Elrindel/Arduino-Flash-Programmer/Schema/arduino-flash-programmer-sch.jpg

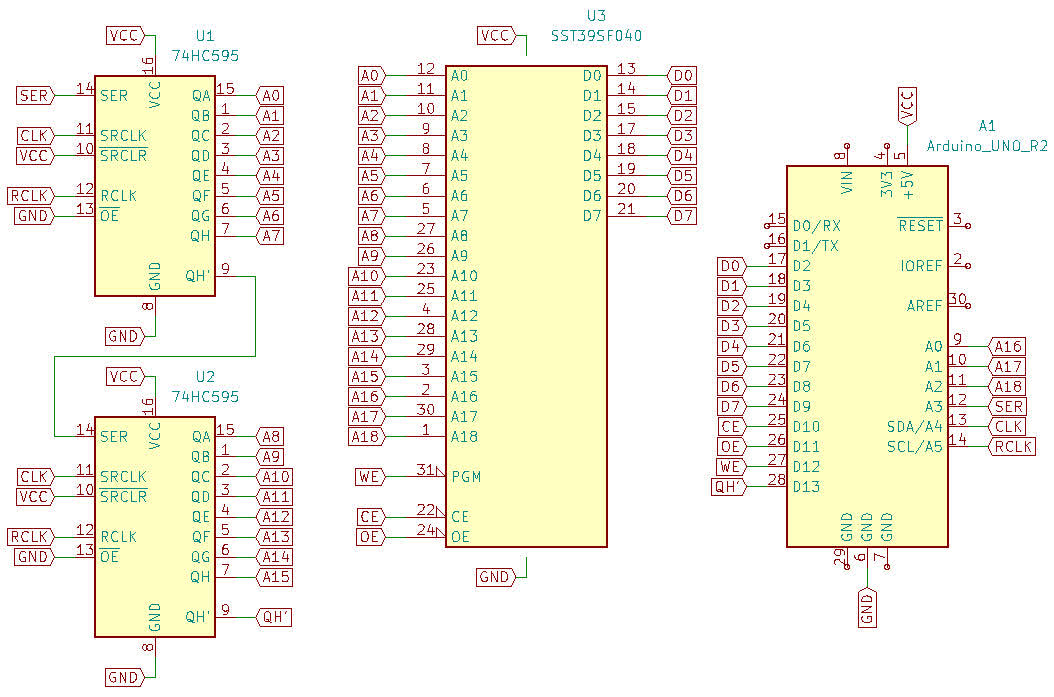
Schema/arduino-flash-programmer-sch.jpg
