Elrindel/Arduino-Flash-Programmer/Schema/FlashProgrammer.sch

## KiCad design Schema/FlashProgrammer.sch (2020-07-18)

Schematic: FlashProgrammer.sch

Parts:
A1: Arduino_UNO_R2
U1, U2: 74HC595; DIP-16_W7.62mm_Socket_LongPads
U3: SST39SF040; DIP-32_W15.24mm_Socket_LongPads
