Elrindel/Arduino-Flash-Programmer/(threads)

Thread 1 (2021-01-12):

Please confirm SST39SF010 and Linux compatibility

evgkarasev, 2021-01-12:
Hi!

Thank you for making your excellent piece of work public!

I have reviewed a lot of Arduino EEPROM programmers available within github and found that yours is capable to address large ROMs and use optimal hardware.
Please could confirm the compatibility with SST39SF010 and Linux environment as well.

Elrindel, 2021-01-12:
Hello,

Thank you for the comment.

The SST39SF010 flash memory is fully compatible (using the default sequence 1)!

I tested with a SST39SF040 and everything is OK.

The Python program is Linux compatible. You have to specify the right serial port with the -p argument.

evgkarasev, 2021-01-13:
Hi!

Thank you for your prompt reply!

Just read the newspaper article about retrocomputing:

https://www.nytimes.com/2021/01/08/style/retrocomputing.html

And remember our conversation, so it seems that flash ROM based floppy
emulators for old PCs could be a good business!

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

evgkarasev, 2021-01-16:
Hi, Elrindel!

Just completed the assembly on breadboard and flashed the Arduino with the code from Arduino/Uno-Nano/ folder.

I use Arduino Nano V3 and AT29C010A flash, assembled the schema without any modifications.

I run the code under Ubuntu 20.04.

# sudo chmod a+rw /dev/ttyUSB0
# python3 flashprogrammer.py -p /dev/ttyUSB0 -c I -x
FF FF
# python3 flashprogrammer.py -p /dev/ttyUSB0 -c E
Do you really want to erase the memory? [Y/n]y
# python3 flashprogrammer.py -p /dev/ttyUSB0 -c W -a 0 TEST WRITE DATA
[+] Ready to write 15 bytes
[+] Write 15/15 (15 bytes)
# python3 flashprogrammer.py -p /dev/ttyUSB0 -c R -a 0 -l 32 -x
E0 FF FF FF FF FF FF FF FF FF FF FF FF FF FF FF FF FF FF FF FF FF FF FF FF FF FF FF FF FF FF FF%

So it seems it doesn't work as expected...

Elrindel, 2021-01-16:
Hello,

I don't know why it doesn't work with your AT29C010A.
This memory does use sequence 1 like the SST39SF010.

I don't have an AT29C010A or any other Atmel flash memory, so I can't test.

Have you tested with a SST39SF010?

evgkarasev, 2021-01-16:
According to vendor datasheets AT29C010 and SST39SF010 are interchangeable, so don't think it could be an issue.
Now I trace the data on D0-D7 with logical analyzer, and it seems the issue is the timing...

Elrindel, 2021-01-16:
You can try the version for other Arduino boards: https://github.com/Elrindel/Arduino-Flash-Programmer/blob/master/Arduino/Other/ArduinoFlashProgrammer/ArduinoFlashProgrammer.ino
(This code is slower than the Uno/Nano version)

evgkarasev, 2021-01-16:
$ sigrok-cli --driver fx2lafw --config samplerate=500000 --channels D0,D1,D2,D3,D4,D5,D6,D7 --continuous -P parallel
parallel-1: d5
parallel-1: ca
parallel-1: df
parallel-1: ab
parallel-1: d5
parallel-1: d7
parallel-1: c2
parallel-1: d5
parallel-1: df
parallel-1: df
parallel-1: ca
parallel-1: df
parallel-1: aa
parallel-1: d5
parallel-1: df
parallel-1: 9f
parallel-1: ff
parallel-1: df
parallel-1: cb
parallel-1: dd
parallel-1: ca
parallel-1: d7
parallel-1: ff
parallel-1: d5
parallel-1: ca
parallel-1: df
parallel-1: c4
parallel-1: d5
parallel-1: df
parallel-1: ab
parallel-1: ff
parallel-1: ca
parallel-1: d7
parallel-1: c2
parallel-1: d5
parallel-1: ca
parallel-1: d3
parallel-1: ff
parallel-1: d5
parallel-1: ca
parallel-1: df
parallel-1: aa
parallel-1: d5
parallel-1: df
parallel-1: ff
parallel-1: c0
parallel-1: df
parallel-1: ff
parallel-1: ca
parallel-1: d7
parallel-1: ab
parallel-1: d5
parallel-1: ca
parallel-1: df
parallel-1: ff
parallel-1: ff
parallel-1: ff
parallel-1: ff
parallel-1: ff
parallel-1: ff
parallel-1: ff
parallel-1: ff
parallel-1: ff
parallel-1: ff
parallel-1: ff
parallel-1: ff
parallel-1: 7f
parallel-1: ff
parallel-1: ff
parallel-1: ff
parallel-1: ff
parallel-1: ff
parallel-1: ff
parallel-1: ff
parallel-1: ff
parallel-1: ff
parallel-1: ff
parallel-1: ff
parallel-1: ff
parallel-1: ff
parallel-1: ff
parallel-1: ff

The trace above is for running:
$ python3 flashprogrammer.py -p /dev/ttyUSB0 -c W -a 0 TEST WRITE DATA
[+] Ready to write 15 bytes
[+] Write 15/15 (15 bytes)
$ python3 flashprogrammer.py -p /dev/ttyUSB0 -c R -a 0 -l 32
ÿÿÿÿÿÿÿÿÿÿÿÿÿÿÿÿÿÿÿÿÿÿÿÿÿÿÿÿÿÿÿÿ%

evgkarasev, 2021-01-16:
> You can try the version for other Arduino boards: https://github.com/Elrindel/Arduino-Flash-Programmer/blob/master/Arduino/Other/ArduinoFlashProgrammer/ArduinoFlashProgrammer.ino
> (This code is slower than the Uno/Nano version)

OK, will try

evgkarasev, 2021-01-16:
Just re-flashed the Arduino, and now instead of FF it returns 7F :)
So in general nothing has been changed.

$ python3 flashprogrammer.py -p /dev/ttyUSB0 -c I -x          
7F 7F
$ python3 flashprogrammer.py -p /dev/ttyUSB0 -c W -a 0 TEST WRITE DATA
[+] Ready to write 15 bytes
[+] Write 15/15 (15 bytes)
$ python3 flashprogrammer.py -p /dev/ttyUSB0 -c R -a 0 -l 32 -x
7F 7F 7F 7F 7F 7F 7F 7F 7F 7F 7F 7F 7F 7F 7F 7F 7F 7F 7F 7F 7F 7F 7F 7F 7F 7F 7F 7F 7F 7F 7F 7F%

evgkarasev, 2021-01-16:
Please could you check and reply the python configuration...

Elrindel, 2021-01-16:
The writing sequence starts with these 3 bytes : AA 55 A0

This sequence is repeated for each byte to be written to the memory.

You either have a wiring problem or a problem with the configuration of your logic analyser (for parallel decoding, use WE as a clock signal with a falling edge).

evgkarasev, 2021-01-16:
Thanks, checking the wiring once again...

https://www.futurlec.com/Datasheet/Memory/AT29C010.pdf

evgkarasev, 2021-01-17:
Checked twice, no errors have been found...

The only thought that came in mind, that it could be linux serial driver /dev/ttyUSB0 that requires special care with processing in python... Will check on Windows machine

I have no other idea why it can't work as expected.

Any way, thanks a lot for your time and willingness to help!

Elrindel, 2021-01-17:
I doubt that the problem is related to serial communication.

The sequence bytes (AA 55 A0 for writing) are not sent via serial communication, they are coded in the Arduino program (only the bytes to be written in the memory are sent via serial communication).
These bytes are sent on pins D2 to D9 (via registers PORTD and PORTB for the Uno/Nano code, and via digitalWrite for the other boards). You should see them with your logic analyser.

The message "[+] Ready to write %d bytes" is displayed only if the Arduino is ready to receive data, confirming that the serial communication is working properly.

So if you can't see the sequence bytes with your logic analyser then there is a problem, either in the Arduino or in your wiring.

You can try to remove the flash memory, start writing and see the result on your logic analyser (to make sure it is not your flash memory that is distorting the measurements).

If the measurements are correct without the flash memory, then it is possible that the OE or WE pin is faulty (or the memory chip is dead).

evgkarasev, 2021-01-17:
Thank you for the explanation.

I have a bunch of AT29C010A flash chips bought on AliExpress, so already tried to change the chips - nothing changed.

Honestly speaking, this is my first expirience with Arduino, previously dealt with STM32 blue/black pills only. All the stuff was bought on AliExpress as well. I have tried only simple Blink example with Arduino so far. So next step will be 4-digit-7-segment-shift-register-counter on 74HC595.
https://create.arduino.cc/projecthub/goarray/4-digit-7-segment-shift-register-counter-b7338d

The reason why I spent such time on flashing the ROMs is the intention to build the Nibbler 4-bit 7400 CPU (https://www.bigmessowires.com/nibbler/) to teach my son CPU architecture.

All details that I would like to achieve are here:
https://github.com/pong74ls/Nibbler

evgkarasev, 2021-01-17:
Good evening, Elrindel!

There is good and bad news...

The good one is that Arduino Nano board is fully functional! I have completed the 20x2 LCD output example and it works!
https://github.com/arduino-libraries/LiquidCrystal/tree/master/examples/HelloWorld

And the bad one - similar 20x2 LCD output example with 595 shift register doesn't work
https://github.com/matmunk/LiquidCrystal_74HC595

Thus it seems the problem is 595 shift register chips...
These chips are cheap so will change the whole bunch of them.

Elrindel, 2021-01-17:
Hello,

You can easily test your 74HC595, here is an example: https://www.arduino.cc/en/Tutorial/Foundations/ShiftOut

Good luck!

Closed 2021-08-02.

Thread 2 (2021-04-01):

Programmateur 27C010

ReasK29, 2021-04-01:
Bonjour,

Tout d'abord, merci pour votre réponse.
En stage, je dois réaliser un programmateur pour AT27C010 pour faire de la lecture/écriture cette mémoire. Pour ma part, j'utilise un Raspberry Pi (avec Codeblocks en C). Le problème est que je ne peux pas attaquer directement la prom, le composant est monté sur une carte avec des composants pour serialiser les données.... J'ai routé une carte pour m'interfacer avec la carte existante. Il me reste la partie software à réaliser...
J'ai des séquences déjà décrite à coder en C en fonctions de mes entrées/sorties, j'ai validé ma lecture mais l'écriture me pose des soucis...
Mon sujet te parle t-il ? :)

Elrindel, 2021-04-01:
Bonjour,

Votre mémoire AT27C010 n'est pas compatible avec mon programmateur via Arduino !

En effet, d'après le datasheet de l'AT27C010, l'écriture n'est pas gérée par une séquence mais via la broche VPP qui doit être à 13V.
Page 6 du datasheet : https://ww1.microchip.com/downloads/en/DeviceDoc/doc0321.pdf

On remarque également une augmentation de la tension VCC qui passe de 5V à 6.5V.

Ces tensions plus élevées semblent donc permettre de déclencher l'écriture lorsque la broche PGM passe à l'état bas. Il est ensuite très facile de vérifier que la donnée est bien écrite en repassant PGM à l'état haut puis OE à l'état bas afin de lire l'octet pour confirmer sont écriture.

Au niveau hardware c'est un peu plus contraignant à gérer car il faut pouvoir fournir les différentes tensions nécessaires, mais au niveau software c'est beaucoup plus rapide pour programmer la mémoire !

ReasK29, 2021-04-01:
Je vois, d'accord...
Elrindel, auriez-vous un peu de temps pour regardez mon schéma ?
Cela m'aiderait beaucoup, je bloque vraiment sur la partie programmation

Elrindel, 2021-04-01:
Il est préférable de vous rapprocher d'un forum d'électronique.
Personnellement je suis débutant en électronique.

Tout ce que je peux vous conseiller c'est de bien lire le datasheet du composant pour bien comprendre comment l'utiliser.
Ensuite, si le composant n'est pas directement accessible alors il faut trouver un moyen d'y accéder pour faire ce que vous souhaitez ... mais ce n'est pas forcément toujours possible sans intervenir directement sur le composant. Pour savoir cela il faut étudier/comprendre le schéma.

La programmation va juste consister à jouer avec l'état des GPIO pour envoyer/lire les bons signaux pour communiquer avec la mémoire.
En l'occurrence, si vous utilisez un RPi, les GPIO sont en 3.3V, donc dans tous les cas il faudra une solution hardware pour remonter les signaux au bon niveau pour gérer l'écriture (pour la lecture il est possible que 3.3V soit suffisant, mais je doute que ce soit le cas pour l'écriture).

Donc le plus gros du boulot est sur la partie hardware. De plus, le software va dépendre de vos choix pour la partie hardware ...

Encore une fois, le datasheet est le meilleur support ! Surtout que dans votre cas, le code sera vraiment simple comparé à mon code qui doit gérer des séquences.

ReasK29, 2021-04-01:
J'ai déjà fait l'étude de la carte existante, et la partie hardware est finalisée. J'ai routé une carte sur laquelle sera pluggé le raspberry pi qui s'interface avec la carte existante. On ma donné un fichier excel avec les protocoles à coder : état haut, état bas des sorties. Il ne me reste que la partie software à valider (sans parler de l'intégration à la suite)
Mes fonctions à coder en C :
- Init à adresse 00
- Chargement adresse 13 bits
- Lecture d'une donnée
- écriture d'une donnée

J'ai déjà consulter beaucoup de forum mais je n'avance pas dans mes fonctions en C...
Je pourrai vous montrer le documents excel des fonctions que je dois coder ?

Si ça ne vous dérange pas...

Elrindel, 2021-04-01:
Si vous avez bien réalisé la partie hardware, il ne vous reste donc plus qu'à manipuler les GPIO du RPi.

Il y a énormément de tutos/exemples disponibles sur internet.
Voici les 2 premiers liens que j'ai trouvé et qui me semblent assez complets :
https://elinux.org/RPi_GPIO_Code_Samples
https://silanus.fr/bts/activites/raspberry/gpioRaspberryPi-SN2V1.html

Je n'ai jamais utilisé les GPIO d'un RPi mais de ce que je vois il existe plusieurs façons de procéder mais les différents exemples sont assez simples à comprendre.

Toutes les ressources dont vous avez besoin sont déjà disponibles sur internet et facilement trouvables avec une petite recherche.
L'apprentissage peut demander du temps mais c'est indispensable pour réaliser ce genre de projet soi-même.

Closed 2021-08-02.

Thread 4 (2021-08-02):

Arduino code issue

Dale-Lien, 2021-08-02:
Hi,
in ArduinoFlashProgrammer.ino,
line 190 (for UNO-Nano), line 232(for other):
	int32_t len = arg_to_int(serial_read_arg(), 1);

the parameter '1' mayby should be '-1'?
because the follower code are check
	if(address < 0 || len < 0){
		Serial.println("ERR");
		return;
	}

and the line 115 to 117 (for Other):
	digitalWrite(A0, (address>>16)&1);
	digitalWrite(A0, (address>>17)&1);
	digitalWrite(A0, (address>>18)&1);

should be:
	digitalWrite(A0, (address>>16)&1);
	digitalWrite(A1, (address>>17)&1);
	digitalWrite(A2, (address>>18)&1);

Elrindel, 2021-08-02:
Hello,

The parameter is set to '1' on purpose.
This is the default value for reading. If no length is sent, it will read a single byte.

There was indeed a big mistake in the code of the set_address function in the assignment of the 3 most significant bits.
This is now fixed.

Thanks a lot!

Dale-Lien, 2021-08-02:
Hi,
Thanks your answer.

I has make a clone on Mega2560, and it is work well.

Closed 2021-08-02.
