Elrindel/Arduino-Flash-Programmer/(commit log)

2021-08-02 Fix case sensitive length
    [flashprogrammer.py]
2021-08-02 Fix set_address 3 MSB
    [ArduinoFlashProgrammer.ino]
